j4py/rover_cardenal_cisneros/Esquema.pdf

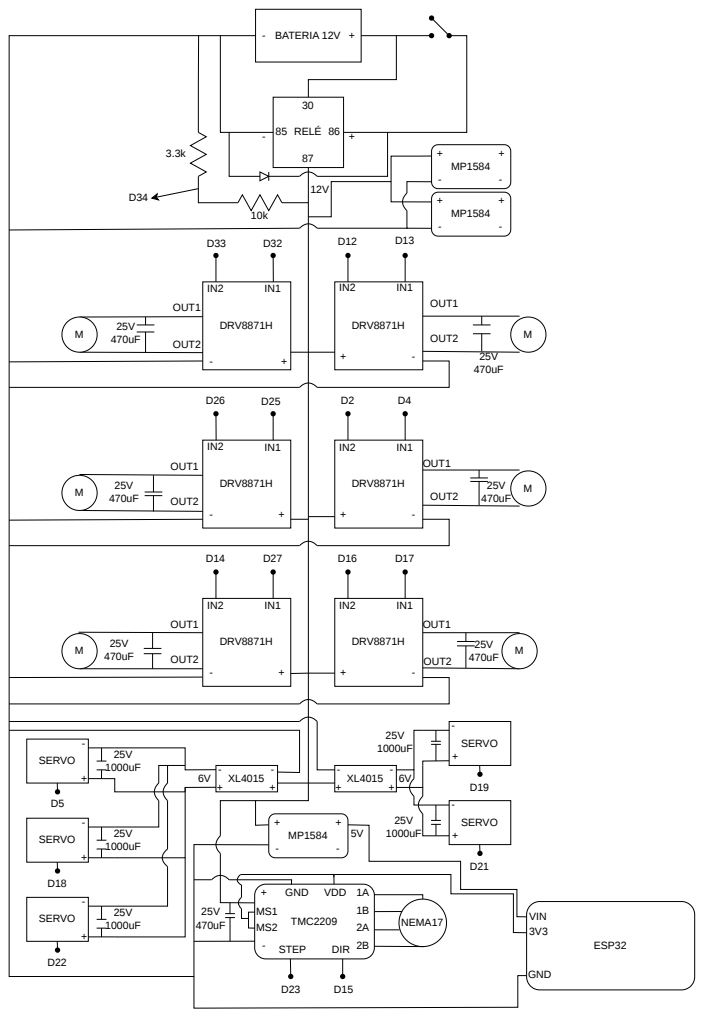
[picture p1: page 1]
