j4py/rover_cardenal_cisneros/(commit log)

2026-06-20 Rover Perseverance — release inicial pública
    Centro de mando web + firmware ESP32 + despliegue automatizado (deploy/).
    Sin credenciales: todo placeholders CAMBIA_*/example.com. Sin historial previo.
2026-06-20 docs: atribuir el proyecto original a HowToMechatronics en el README
2026-06-21 docs(readme): avisar de chmod +x / bash si Permission denied
2026-06-21 feat: migrar puerto de 443 a 8443 en DDNS, correccion de permisos de Mosquitto y enrutamiento Nginx
2026-06-21 fix(deploy): fix short-circuit order for tty detection in bootstrap.sh
